Alexou1209/6-Band-Graphic-EQ-guitar-pedal/docs/complete_pedal.jpg

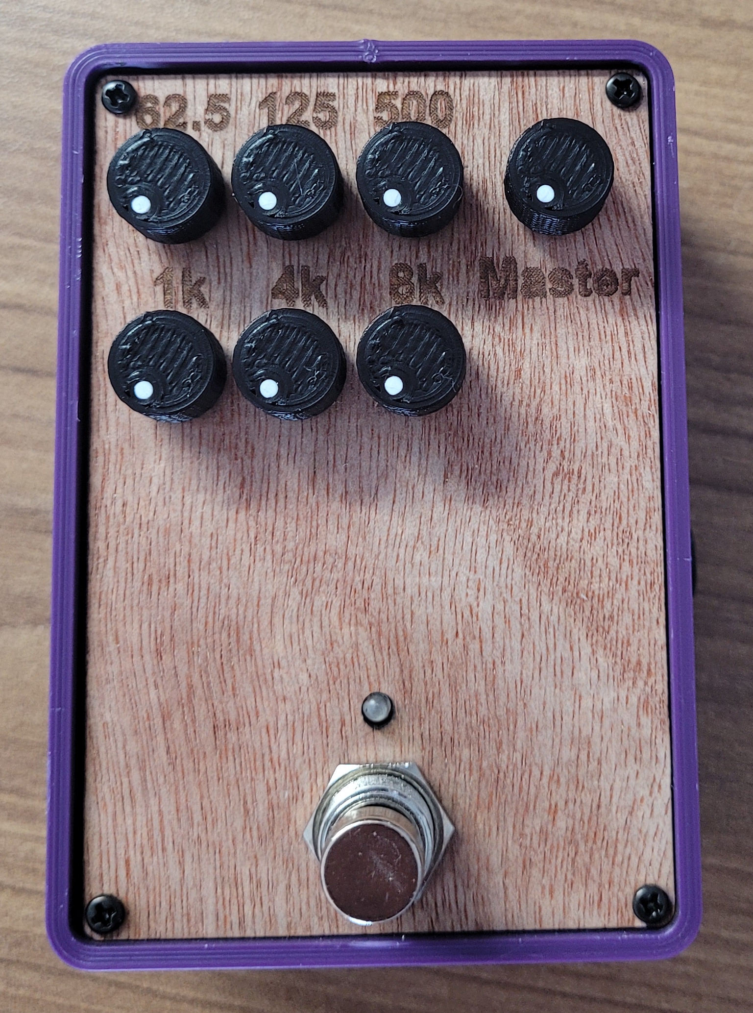
docs/complete_pedal.jpg
