Alexou1209/6-Band-Graphic-EQ-guitar-pedal/3d_models/EQ_PCB.step

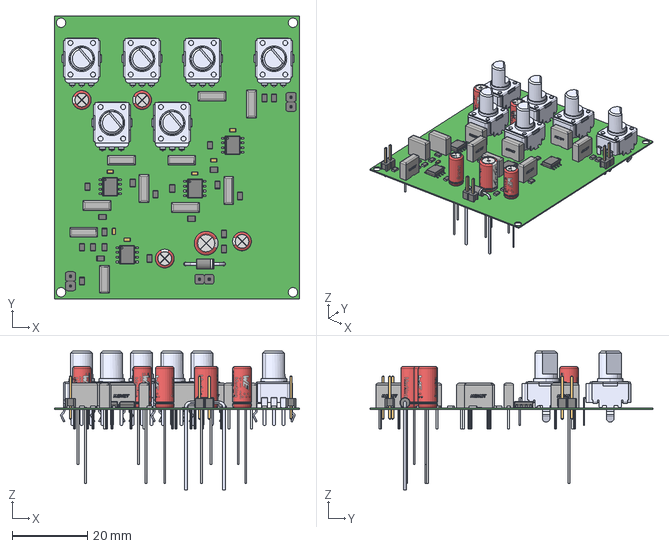
[picture p5: CAD file, 2026-10-25]
3d_models/EQ_PCB.step
65.0 x 75.0 x 36.8 mm
