Alexou1209/6-Band-Graphic-EQ-guitar-pedal/3d_models/Footswitch/GØRVA_MECHANO_3PDT_FOOTSWITCH.STEP

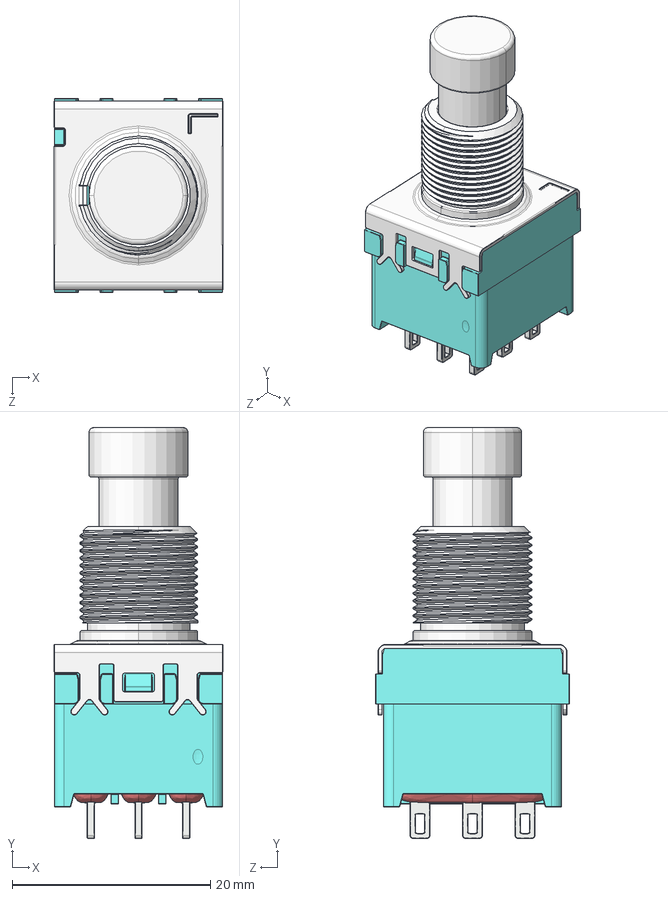
[picture p6: CAD file, 2026-10-25]
3d_models/Footswitch/GØRVA_MECHANO_3PDT_FOOTSWITCH.STEP
17.1 x 41.5 x 19.6 mm
