Alexou1209/6-Band-Graphic-EQ-guitar-pedal/(list of files, cad)

Other CAD files:
3d_models/EQ_Pedal_Box.f3z
3d_models/Footswitch/GØRVA_MECHANO_3PDT_FOOTSWITCH.f3d
