Alexou1209/6-Band-Graphic-EQ-guitar-pedal/3d_models/Faceplate.pdf

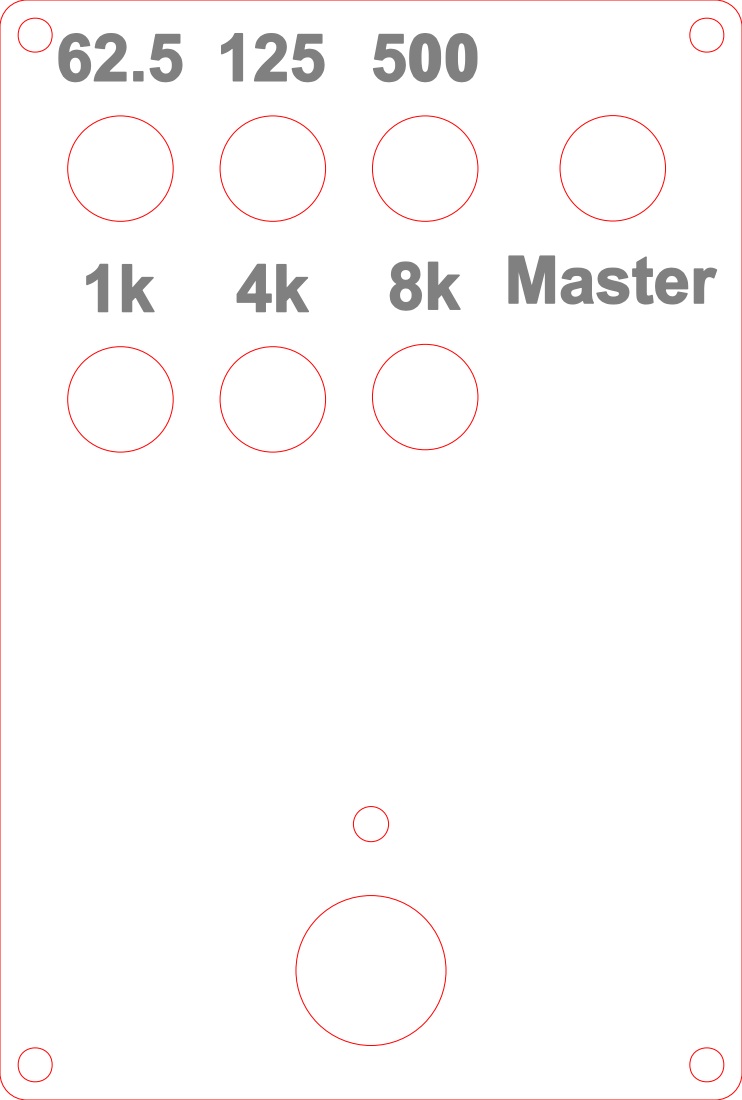
[picture p7: page 1]
