Alexou1209/6-Band-Graphic-EQ-guitar-pedal/(list of files, drawings)

Other design files:
hardware/EQ.PcbDoc
hardware/EQ.SchDoc
hardware/EQ_Guit.PrjPcb
hardware/PcbLib1.PcbLib
hardware/Schlib2.SchLib
